RoboDoig/autonomouse-design/ConstructionManual/Olfactometer1.png

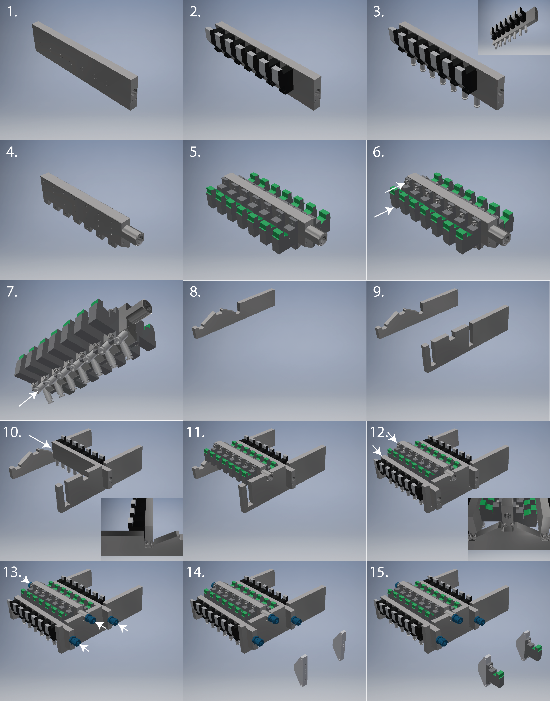
ConstructionManual/Olfactometer1.png
