RoboDoig/autonomouse-design/ConstructionManual/MainFrame2.png

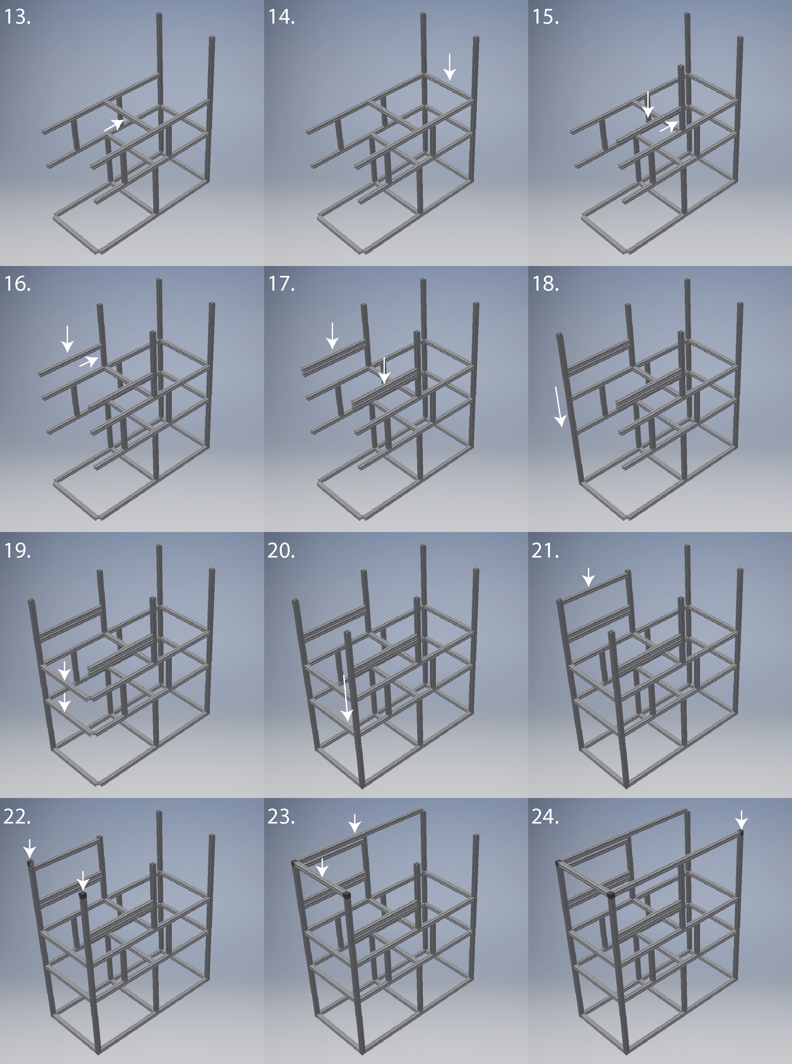
ConstructionManual/MainFrame2.png
