RoboDoig/autonomouse-design/README.md

# autonomouse-design
Design and schematic files for the AutonoMouse system
