RoboDoig/autonomouse-design/Diagrams/BehaviourPort.png

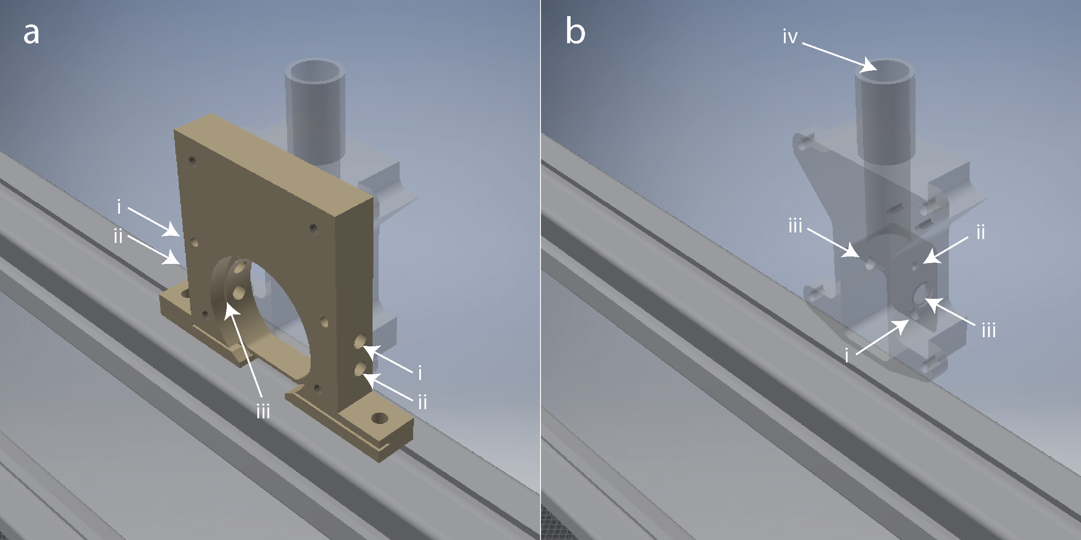
Diagrams/BehaviourPort.png
