RoboDoig/autonomouse-design/Diagrams/CageClean.png

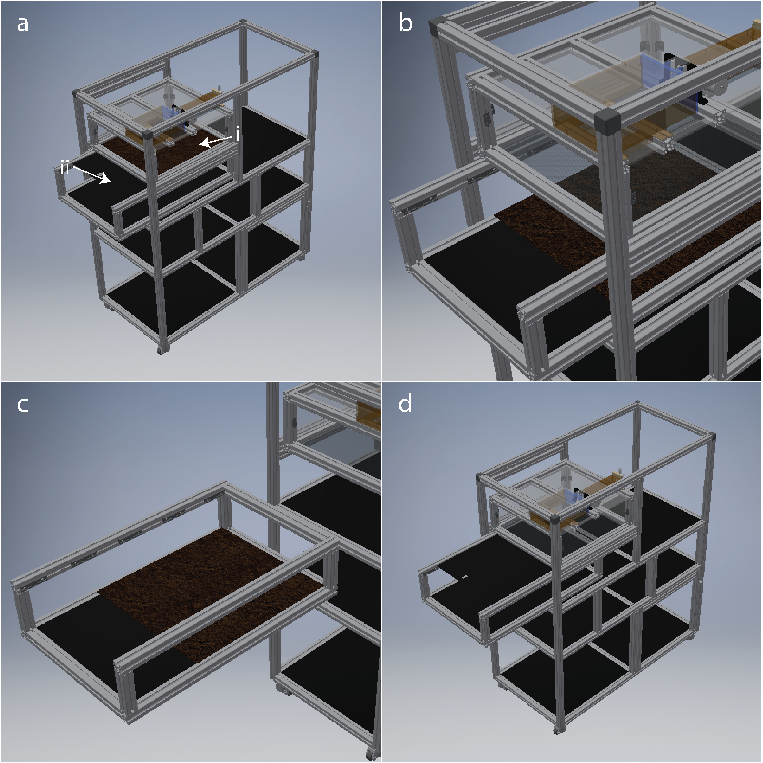
Diagrams/CageClean.png
