RoboDoig/autonomouse-design/Diagrams/FrameOnly.png

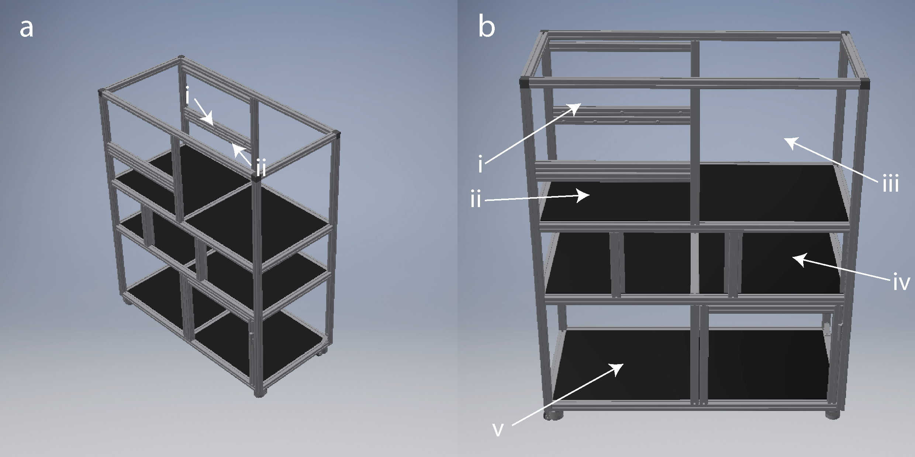
Diagrams/FrameOnly.png
