RoboDoig/autonomouse-design/SystemPictures/Pictures1.png

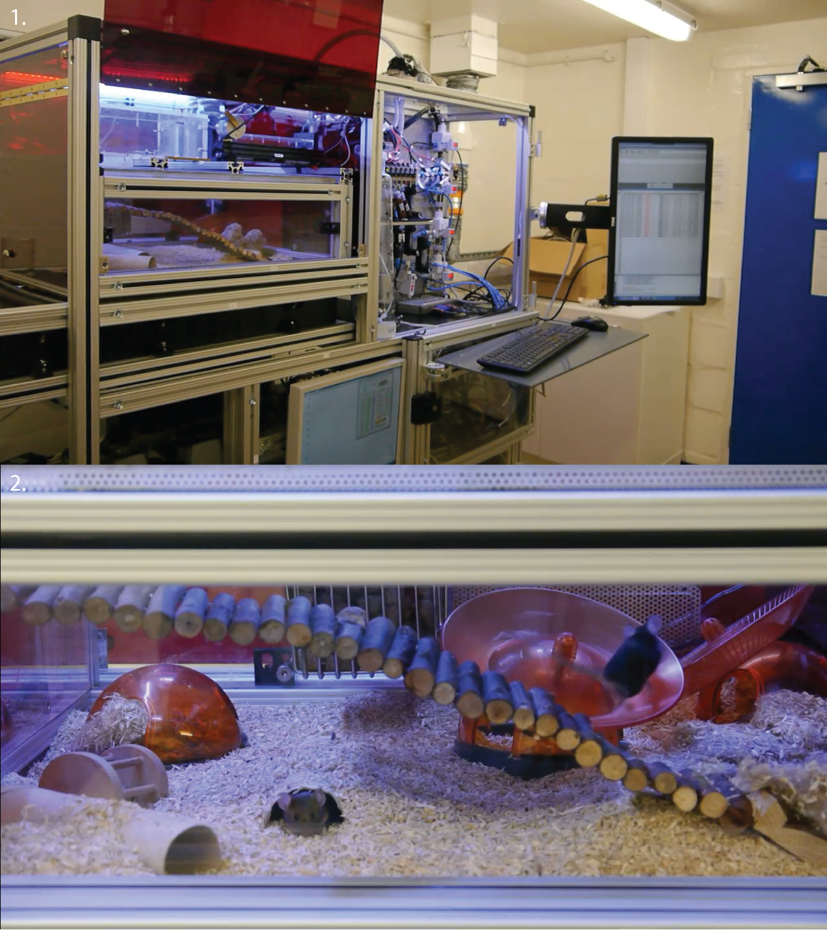
SystemPictures/Pictures1.png
