RoboDoig/autonomouse-design/SystemPictures/Pictures3.png

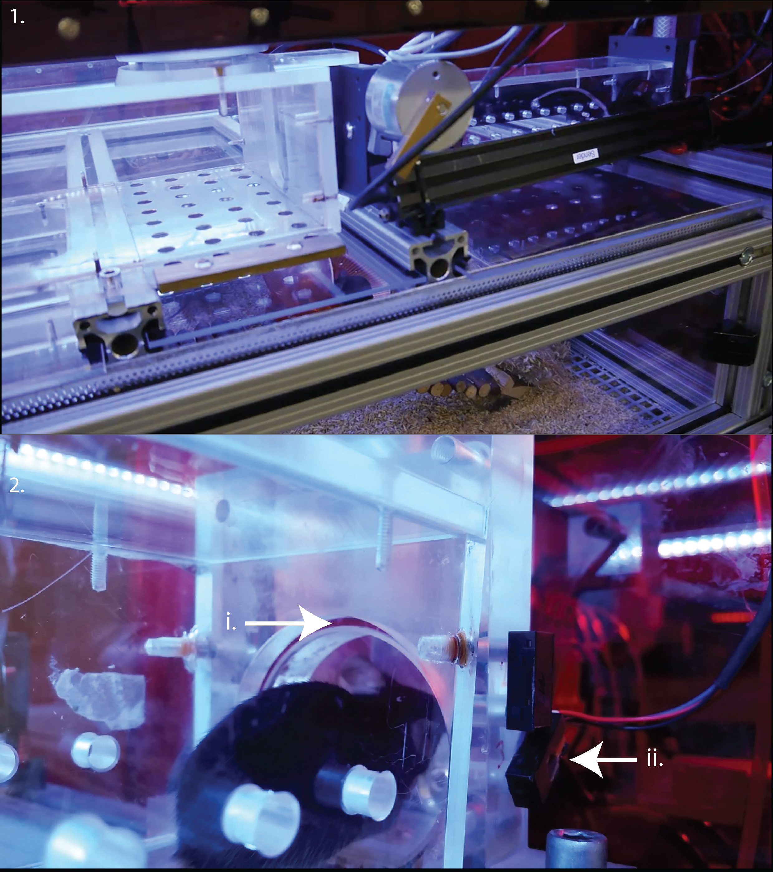
SystemPictures/Pictures3.png
