RoboDoig/autonomouse-design/SystemPictures/Pictures5.png

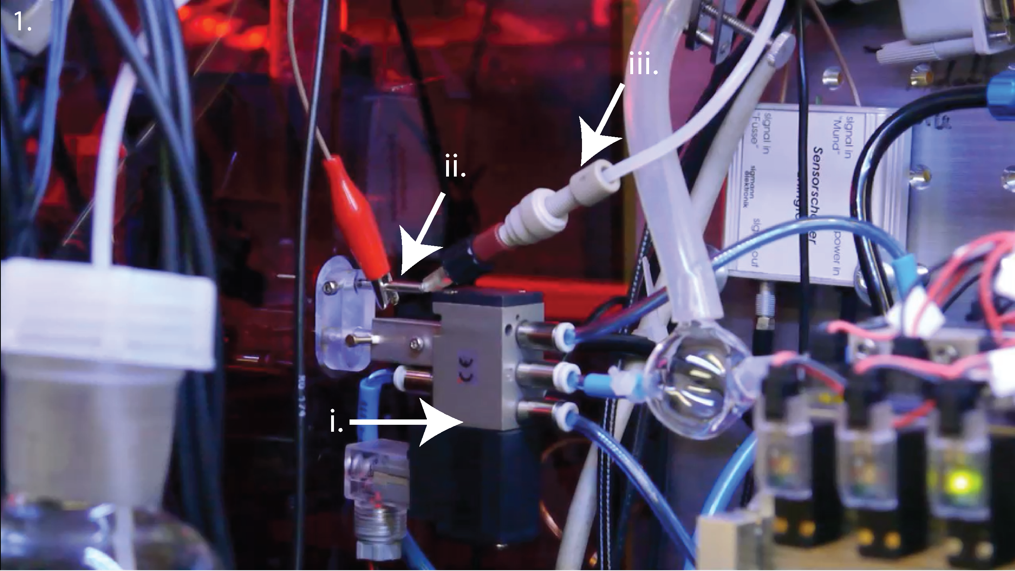
SystemPictures/Pictures5.png
