RoboDoig/autonomouse-design/ConstructionManual/PartsList.xlsx

Sheet: Main Frame
Item Name | Cut Length for Profiles (mm) | Quantity | Supplier | Catalog Code | Notes
Corner piece set cubica PA |  | 4 | MayTec | 1.48.14410
Profile 40x40 | 1627 | 4 | MayTec | 1.11.040040.43S | Cross bushing
Profile 40x40 | 1360 | 8 | MayTec | 1.11.040040.43S | Cross bushing
Profile 40x40 | 620 | 11 | MayTec | 1.11.040040.43S | Cross bushing
Profile 40x40 | 330 | 4 | MayTec | 1.11.040040.43S | Cross bushing
Profile 40x40 | 550 | 2 | MayTec | 1.11.040040.43S | Cross bushing
Profile 40x40 | 627 | 2 | MayTec | 1.11.040040.43S | Cross bushing
Profile 40x40 | 660 | 5 | MayTec | 1.11.040040.43S | Cross bushing
Profile 40x40 | 545 | 2 | MayTec | 1.11.040040.43S | Optional, cross bushing
Profile 40x40 | 572 | 1 | MayTec | 1.11.040040.43S | Optional, cross bushing
Slot roller |  | 14 | MayTec | 1.67.42E3M8
Hinges |  | 1 | MayTec | 1.62.842032085
Locking castor with plate |  | 4 | MayTec | 1.45.80200.073
Mounting block |  | 40 | MayTec | 1.64.153030.2 | Useful to order more for attachments etc.
Bottom plate |  | 6 | Custom (see repo)
Special mounting profile | 329 | 4 | MayTec | 1.19.19040 | Optional, requires drilling for installation

Sheet: Cleaning Chamber
Item Name | Cut Length for Profiles (mm) | Quantity | Supplier | Catalog Code | Notes
Profile 40x40 | 529.8 | 3 | MayTec | 1.11.040040.43S | Cross bushing
Profile 40x40 | 950 | 4 | MayTec | 1.11.040040.43S | Cross bushing
Profile 40x40 | 160 | 4 | MayTec | 1.11.040040.43S | Cross bushing
Hanging bracket |  | 10 | MayTec | 1.68.201050
Bottom plate |  | 1 | Custom (see repo)
Cleaning plate |  | 1 | Custom (see repo)

Sheet: Home Cage
Item Name | Cut Length for Profiles (mm) | Quantity | Supplier | Catalog Code | Notes
Profile 40x40 | 660 | 3 | MayTec | 1.11.040040.43S | Cross bushing
Profile 40x40 | 529.8 | 2 | MayTec | 1.11.040040.43S | Cross bushing
Profile 40x40 | 180 | 4 | MayTec | 1.11.040040.43S | Cross bushing
Profile 40x40 | 569.8 | 4 | MayTec | 1.11.040040.43S | Cross bushing
Mouting angle |  | 8 | MayTec | 1.64.5101
Home cage pre-chamber access floor |  | 1 | Custom (see repo)
Access floor 2 |  | 1 | Custom (see repo)
Access floor 3 |  | 1 | Custom (see repo)
Front cage panel removable |  | 2 | Custom (see repo)
Side cage panel removable |  | 2 | Custom (see repo)

Sheet: Behaviour Area
Item Name | Cut Length for Profiles (mm) | Quantity | Supplier | Catalog Code | Notes
Magnet frame |  | 1 | Custom (see repo)
Pre-chamber floor |  | 1 | Custom (see repo)
Pre-chamber wall |  | 1 | Custom (see repo)
Pre-chamber wall 2 |  | 1 | Custom (see repo)
Pre-chamber wall 3 |  | 1 | Custom (see repo)
Pre-chamber roof |  | 1 | Custom (see repo)
Pre-chamber front panel |  | 1 | Custom (see repo)
Pre-chamber linker |  | 1 | Custom (see repo)
Tunnel wall |  | 2 | Custom (see repo)
Tunnel roof |  | 1 | Custom (see repo)
Port linker |  | 1 | Custom (see repo)
Sensor port |  | 1 | Custom (see repo)
Spacer |  | 2 | Custom (see repo)
Pre-chamber mesh floor |  | 1 | Custom (see repo)
Tunnel mesh floor |  | 1 | Custom (see repo)
Motor holder |  | 1 | Custom (see repo)
Motor (110 degrees, 50mm 11W 24VDC) |  | 1 | RS Components | 400-8991
Door pole coupling |  | 1 | Custom (see repo)
Door pole |  | 1 | Custom (see repo)
Door adapter |  | 1 | Custom (see repo)
Door

Sheet: Sensors and Actuators
Item Name | Cut Length for Profiles (mm) | Quantity | Supplier | Catalog Code | Notes
IR beam detectors (PIE310/PID310D) |  | 10 | Kodenshi/Farnell | 1182343
Water pump (mzr-2521) |  | 1 | Mikrosysteme GmBH | 11 01 01 03
Pump controller (S-ND) |  | 1 | Mikrosysteme GmBH | 66 02 01 01
Pump cable extension |  | 1 | Mikrosysteme GmBH | 92 00 09 35
Pump tubing (0.5m) (1/8") |  | 2 | Mikrosysteme GmBH | 55 02 02 00
Pump filter (F-UP2) |  | 1 | Mikrosysteme GmBH | 54 02 01 01
Tubing screw insert (PEEK) |  | 1 | Mikrosysteme GmBH | 51 01 02 02
Check valve RSC-UP-210 |  | 1 | Mikrosysteme GmBH | 41 03 01 00
Fluid adapter (PEEK) |  | 1 | Mikrosysteme GmBH | 52 02 03 02
Water port (ID 0.16 mm) |  | 1 | Mikrosysteme GmBH | 58 01 09 06
RFID single coil antenna (52mm diameter) |  | 1
RFID decoder |  | 1 | Trovan | LID-665 OEM

Sheet: Connectors
Item Name | Cut Length for Profiles (mm) | Quantity | Supplier | Catalog Code | Notes
Universal connector |  | 100 | MayTec | 1.21.4E0E | Useful to order more (~50) for subsequent connections
T-nut (M6) |  | 100 | MayTec | 1.32.4EM6 | Useful to order more (~50) for subsequent connections
T-nut (M8) |  | 14 | MayTec | 1.70.10EM8
Quick Lock (E slot) |  | 8 | MayTec | 1.32.4F2M4.25
Quick Lock (Bolt) |  | 8 | MayTec | 1.64.5419 | For different panel thicknesses use different Hmax value. Hmax should be > panel thickness
Profile end cap |  |  | MayTec | 1.42.20404.2 | Optional (caps off hard edges of profiles)
Installation ring |  |  | MayTec | 1.71.30365 | Optional (useful for cable organisation)
T-nut (M5) |  |  | MayTec | 1.32.4EM5 | Optional (attachment for installation rings)

Sheet: Olfactometer
Item Name | Cut Length for Profiles (mm) | Quantity | Supplier | Catalog Code | Notes
Front holder |  | 1 | Custom (see repo)
Back holder |  | 1 | Custom (see repo)
Input valve block (left) |  | 1 | Custom (see repo)
Input valve block (right) |  | 1 | Custom (see repo)
Main valve block |  | 1 | Custom (see repo)
Input valve |  | 14 | Asco / Numatics | 18801088
Main valve |  | 14 | Asco / Numatics | SCS067A028
Pre-line valve |  | 2 | Asco / Numatics | SCS067A108
Straight threaded-to-tube adapter, M5 x 0.8, push in 4mm |  | 28 | SMC | KQ2S04-M5N
Quick tubing connector |  | 10 | Festo | 2027 CK-1/8-PK-4
Hex socket cap screw (M3, 10cm) |  | 6 | RS Pro | 660-4636
Hex socket cap screw (M3, 6cm) |  | 32 | RS Pro | 280-981
Subbase for main valve |  | 2 | Asco / Numatics | 36100040
Subbase adapter |  | 6 | Custom (see repo)
