RoboDoig/autonomouse-design/(list of files, cad)

Other CAD files:
AutonoMouseSchematics/AccessFloor2.ipt
AutonoMouseSchematics/AccessFloor3.ipt
AutonoMouseSchematics/AutonoMouse.iam
AutonoMouseSchematics/BottomPlate.ipt
AutonoMouseSchematics/BottomPlate2.ipt
AutonoMouseSchematics/BottomPlate3.ipt
AutonoMouseSchematics/CageFloor.ipt
AutonoMouseSchematics/CleaningPlate.ipt
AutonoMouseSchematics/Door.ipt
AutonoMouseSchematics/DoorAdapter.ipt
AutonoMouseSchematics/DoorPole.ipt
AutonoMouseSchematics/DoorPoleCoupling.ipt
AutonoMouseSchematics/FrontCagePanelRemovable.ipt
AutonoMouseSchematics/HomeCagePreChamberAccessFloor.ipt
AutonoMouseSchematics/MagnetFrame.ipt
AutonoMouseSchematics/May Tec 1_47_225160_2_Floor mounting plate_schwarz-Pulverbeschichtet.ipt
AutonoMouseSchematics/May Tec 1_48_14410_Corner piece set cubic PA.ipt
AutonoMouseSchematics/May Tec 1_63_14041_3_Clamping stud 40x40.ipt
AutonoMouseSchematics/May Tec 1_63_14041_Base plates.ipt
AutonoMouseSchematics/May Tec 1_63_14041_Clamping lever 80.ipt
AutonoMouseSchematics/May Tec 1_64_153030_2_Mounting blocks GD-Zn_schwarz 0.ipt
AutonoMouseSchematics/May Tec 1_64_5101__Mounting angle.ipt
AutonoMouseSchematics/May Tec 1_71_30365_Installation ring_36_5.ipt
AutonoMouseSchematics/MayTec 1_11_030030_43SP_Profile 30x30_ 4F, SP_50_Detail_(0;0,0,0).ipt
AutonoMouseSchematics/MayTec 1_11_030030_43SP_Profile 30x30_ 4F, SP_910_Detail_(0;0,0,0).ipt
AutonoMouseSchematics/MayTec 1_11_040040_43S_Profile 40x40, 4E, S_1360_Detail_(0;0,0,0).ipt
AutonoMouseSchematics/MayTec 1_11_040040_43S_Profile 40x40, 4E, S_160_Detail_(0;0,0,0).ipt
AutonoMouseSchematics/MayTec 1_11_040040_43S_Profile 40x40, 4E, S_1627_Detail_(0;0,0,0).ipt
AutonoMouseSchematics/MayTec 1_11_040040_43S_Profile 40x40, 4E, S_180_Detail_(0;0,0,0).ipt
AutonoMouseSchematics/MayTec 1_11_040040_43S_Profile 40x40, 4E, S_330_Detail_(0;0,0,0).ipt
AutonoMouseSchematics/MayTec 1_11_040040_43S_Profile 40x40, 4E, S_529_8_Detail_(0;0,0,0).ipt
AutonoMouseSchematics/MayTec 1_11_040040_43S_Profile 40x40, 4E, S_545_Detail_(0;0,0,0).ipt
AutonoMouseSchematics/MayTec 1_11_040040_43S_Profile 40x40, 4E, S_550_Detail_(0;0,0,0).ipt
AutonoMouseSchematics/MayTec 1_11_040040_43S_Profile 40x40, 4E, S_569_8_Detail_(0;0,0,0).ipt
AutonoMouseSchematics/MayTec 1_11_040040_43S_Profile 40x40, 4E, S_572_Detail_(0;0,0,0).ipt
AutonoMouseSchematics/MayTec 1_11_040040_43S_Profile 40x40, 4E, S_609_8_Detail_(0;0,0,0).ipt
AutonoMouseSchematics/MayTec 1_11_040040_43S_Profile 40x40, 4E, S_620_Detail_(0;0,0,0).ipt
AutonoMouseSchematics/MayTec 1_11_040040_43S_Profile 40x40, 4E, S_627_Detail_(0;0,0,0).ipt
AutonoMouseSchematics/MayTec 1_11_040040_43S_Profile 40x40, 4E, S_660_Detail_(0;0,0,0).ipt
AutonoMouseSchematics/MayTec 1_11_040040_43S_Profile 40x40, 4E, S_700_Detail_(0;0,0,0).ipt
AutonoMouseSchematics/MayTec 1_11_040040_43S_Profile 40x40, 4E, S_740_Detail_(0;0,0,0).ipt
AutonoMouseSchematics/MayTec 1_11_040040_43S_Profile 40x40, 4E, S_950_Detail_(0;0,0,0).ipt
AutonoMouseSchematics/MayTec 1_19_19040_19 inch special profile, PG 40_329.ipt
AutonoMouseSchematics/MayTec 1_45_80200_073_Locking castor 200kg, with plate - Kopie.ipt
AutonoMouseSchematics/MayTec 1_45_80200_073_Locking castor 200kg, with plate.ipt
AutonoMouseSchematics/MayTec 1_46_20639_Angle Alu 60x60, D9_0, B30.ipt
AutonoMouseSchematics/MayTec 1_62_842032085_Alu hinges, heavy, type 20 PG 40 (0).ipt
AutonoMouseSchematics/MayTec 1_62_842032085_Alu hinges, heavy, type 20 PG 40 (180).ipt
AutonoMouseSchematics/MayTec 1_62_842032085_Alu hinges, heavy, type 20 PG 40 (90).ipt
AutonoMouseSchematics/MayTec 1_67_42E3M8_Slot roller E3.ipt
AutonoMouseSchematics/MayTec 1_68_201050_Hanging bracket.ipt
AutonoMouseSchematics/MeshFloor.ipt
AutonoMouseSchematics/Motor.ipt
AutonoMouseSchematics/MotorHolder.ipt
AutonoMouseSchematics/PortLinker.ipt
AutonoMouseSchematics/PreChamberFloor.ipt
AutonoMouseSchematics/PreChamberFrontPanel.ipt
AutonoMouseSchematics/PreChamberLinker.ipt
AutonoMouseSchematics/PreChamberRoof.ipt
AutonoMouseSchematics/PreChamberWall.ipt
AutonoMouseSchematics/PreChamberWall2.ipt
AutonoMouseSchematics/PreChamberWall3.ipt
AutonoMouseSchematics/SensorPort.ipt
AutonoMouseSchematics/SideCagePanelRemovable.ipt
AutonoMouseSchematics/Spacer.ipt
AutonoMouseSchematics/TunnelRoof.ipt
AutonoMouseSchematics/TunnelWall.ipt
OlfactometerSchematics/2027 CK-1_8-PK-4.ipt
OlfactometerSchematics/BackHolder.ipt
OlfactometerSchematics/FrontHolder.ipt
OlfactometerSchematics/InputBlockLeft.ipt
OlfactometerSchematics/InputBlockRight.ipt
OlfactometerSchematics/MainBlock.ipt
OlfactometerSchematics/MainValve.ipt
OlfactometerSchematics/NumaticsValve.ipt
OlfactometerSchematics/OldVersions/2027 CK-1_8-PK-4.0001.ipt
OlfactometerSchematics/OldVersions/BackHolder.0002.ipt
OlfactometerSchematics/OldVersions/FrontHolder.0003.ipt
OlfactometerSchematics/OldVersions/InputBlockLeft.0011.ipt
OlfactometerSchematics/OldVersions/InputBlockRight.0012.ipt
OlfactometerSchematics/OldVersions/MainBlock.0010.ipt
OlfactometerSchematics/OldVersions/MainValve.0002.ipt
OlfactometerSchematics/OldVersions/NumaticsValve.0004.ipt
OlfactometerSchematics/OldVersions/Olfactometer.0006.iam
OlfactometerSchematics/OldVersions/PipeFitting.0002.ipt
OlfactometerSchematics/OldVersions/Subbase.0002.ipt
OlfactometerSchematics/OldVersions/SubbaseAdapter.0001.ipt
OlfactometerSchematics/Olfactometer.iam
OlfactometerSchematics/PipeFitting.ipt
OlfactometerSchematics/Subbase.ipt
OlfactometerSchematics/SubbaseAdapter.ipt
