RoboDoig/autonomouse-design/ConstructionManual/BehaviourPort1.png

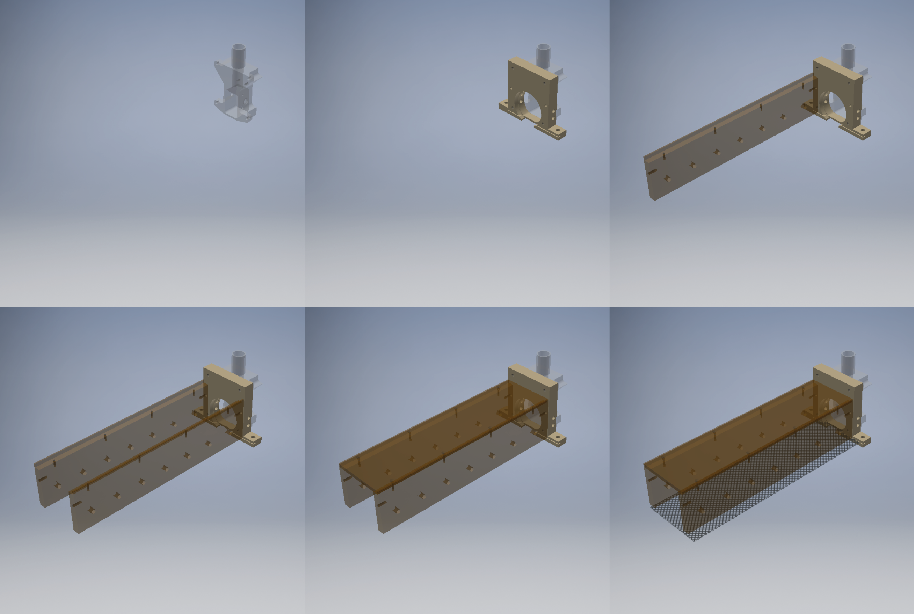
ConstructionManual/BehaviourPort1.png
