RoboDoig/autonomouse-design/ConstructionManual/CleaningBin1.png

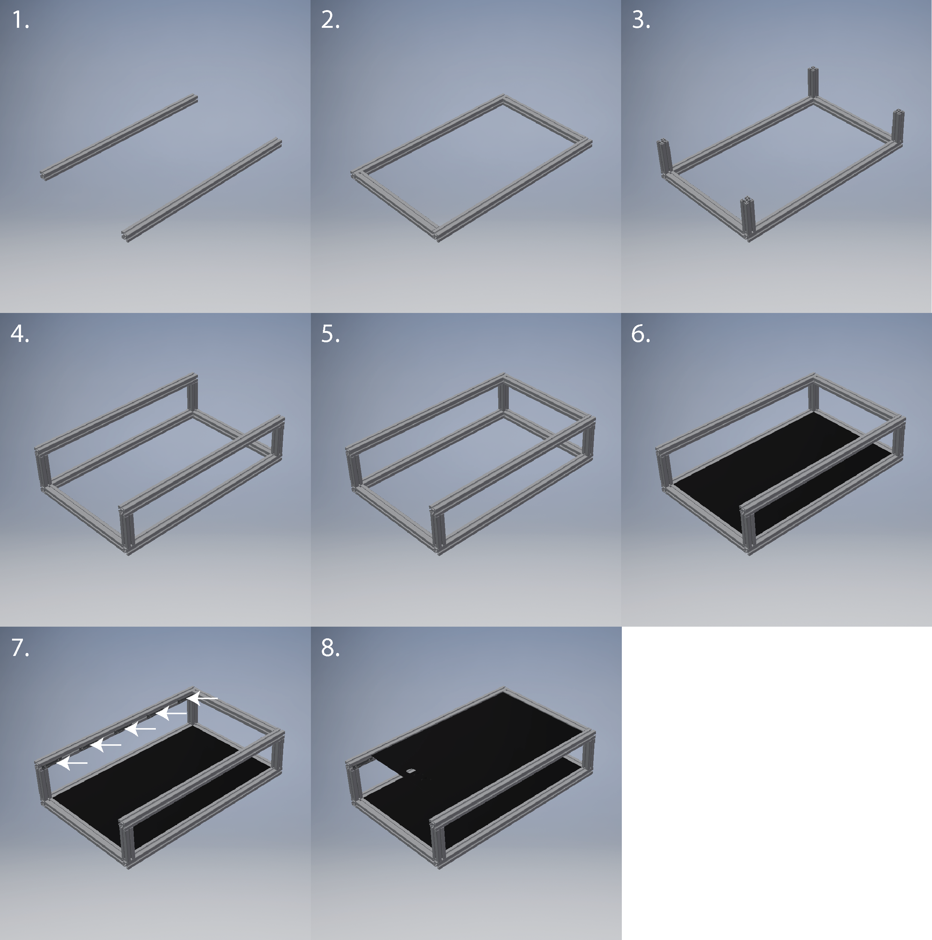
ConstructionManual/CleaningBin1.png
