RoboDoig/autonomouse-design/ConstructionManual/DoorMechanism1.png

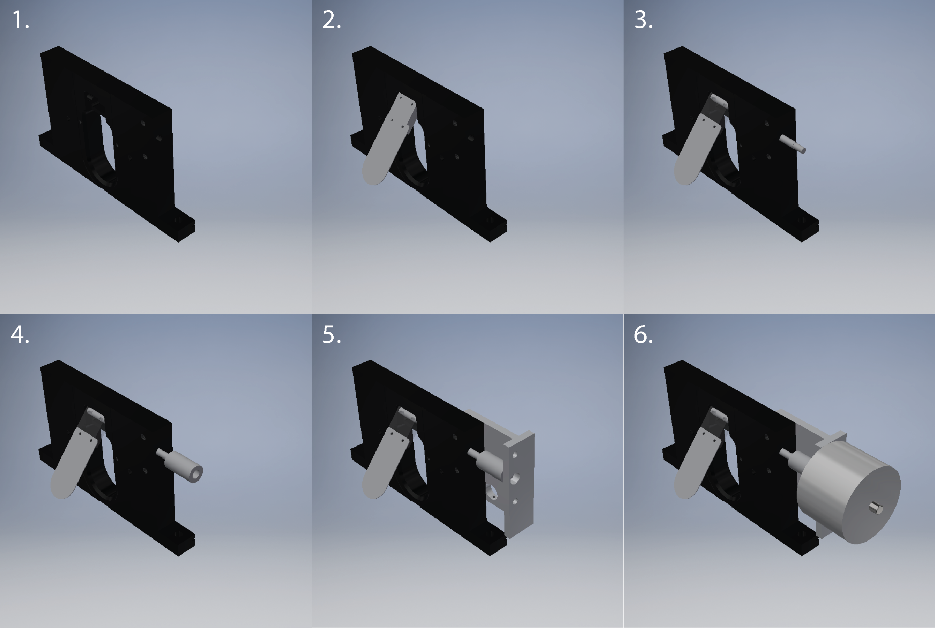
ConstructionManual/DoorMechanism1.png
