RoboDoig/autonomouse-design/ConstructionManual/MainFrame1.png

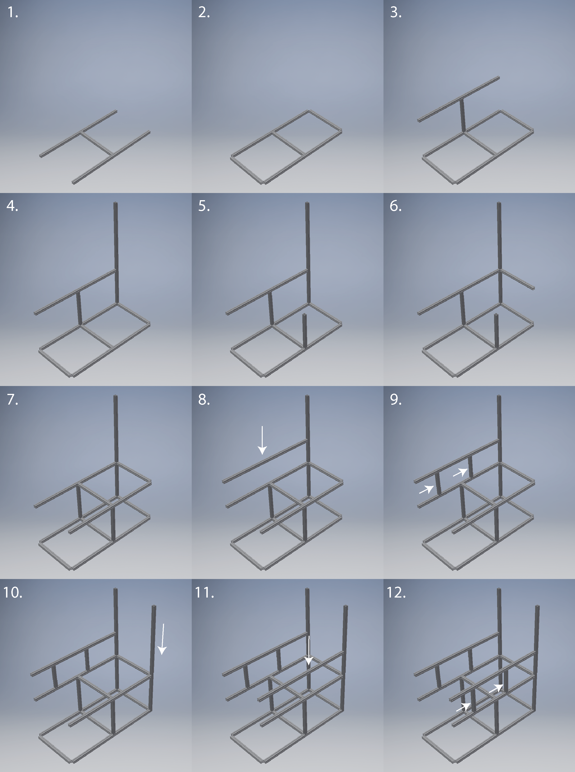
ConstructionManual/MainFrame1.png
