RoboDoig/autonomouse-design/ConstructionManual/MainFrame3.png

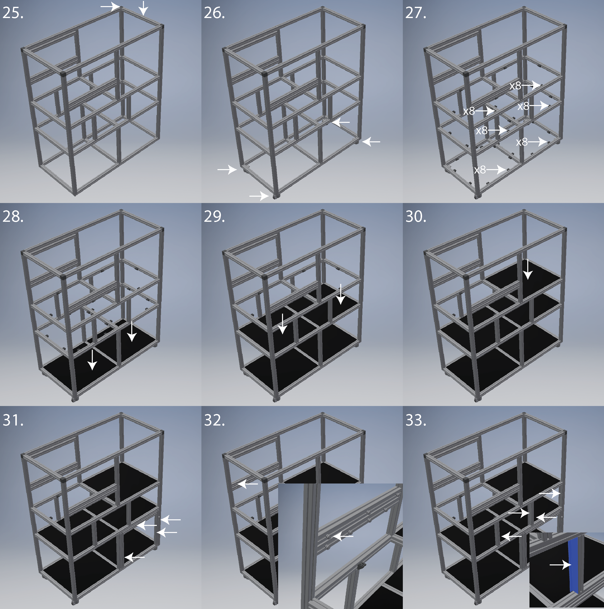
ConstructionManual/MainFrame3.png
