RoboDoig/autonomouse-design/ConstructionManual/Olfactometer2.png

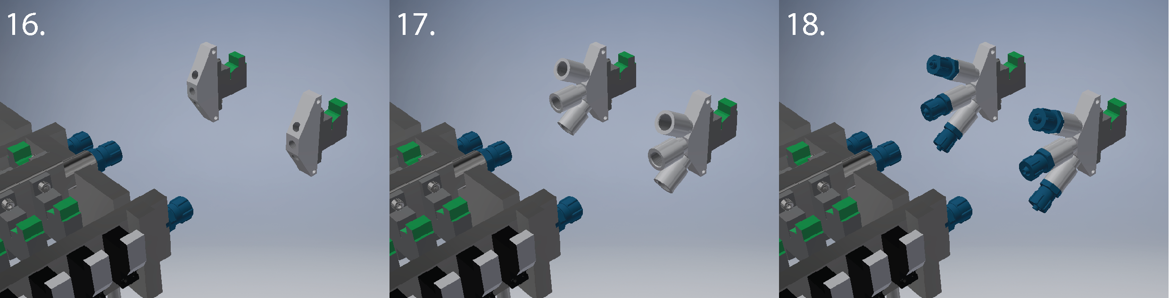
ConstructionManual/Olfactometer2.png
