RoboDoig/autonomouse-design/ConstructionManual/PreChamber1.png

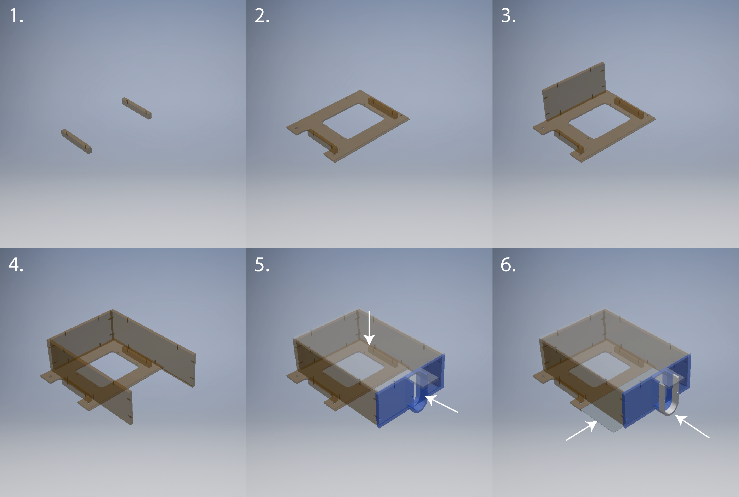
ConstructionManual/PreChamber1.png
