RoboDoig/autonomouse-design/Diagrams/CageConstruction.png

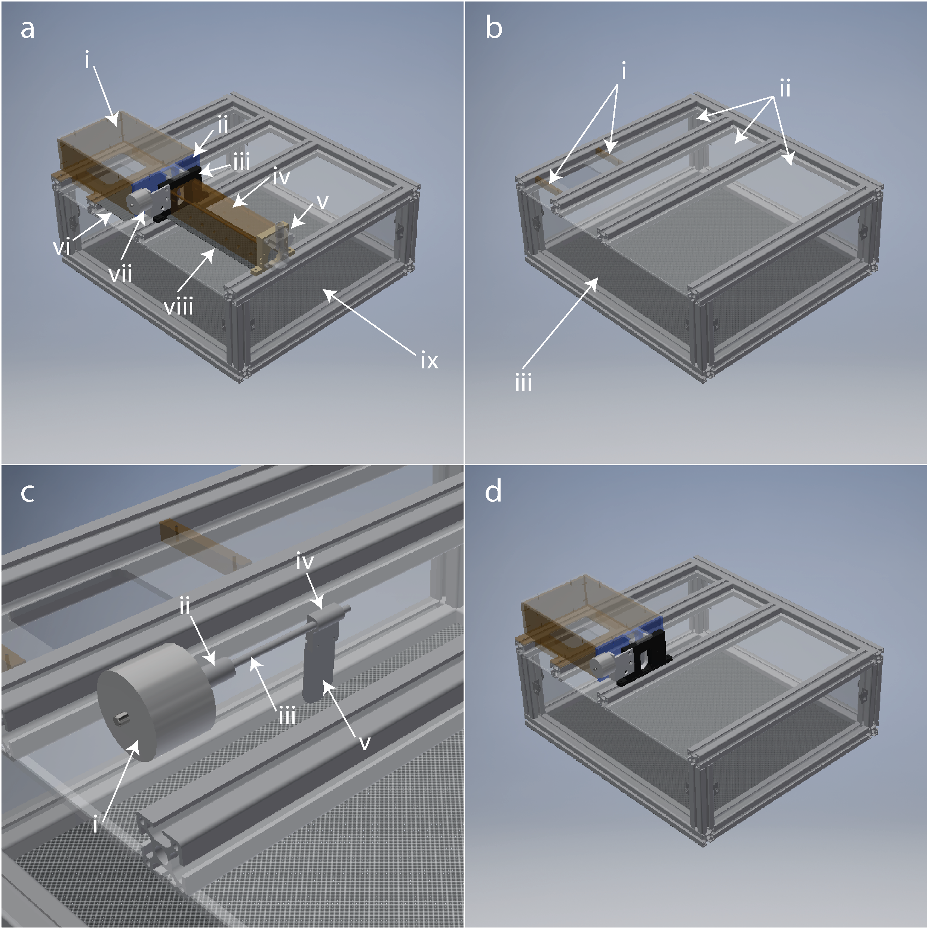
Diagrams/CageConstruction.png
