RoboDoig/autonomouse-design/Diagrams/DoorOperation.png

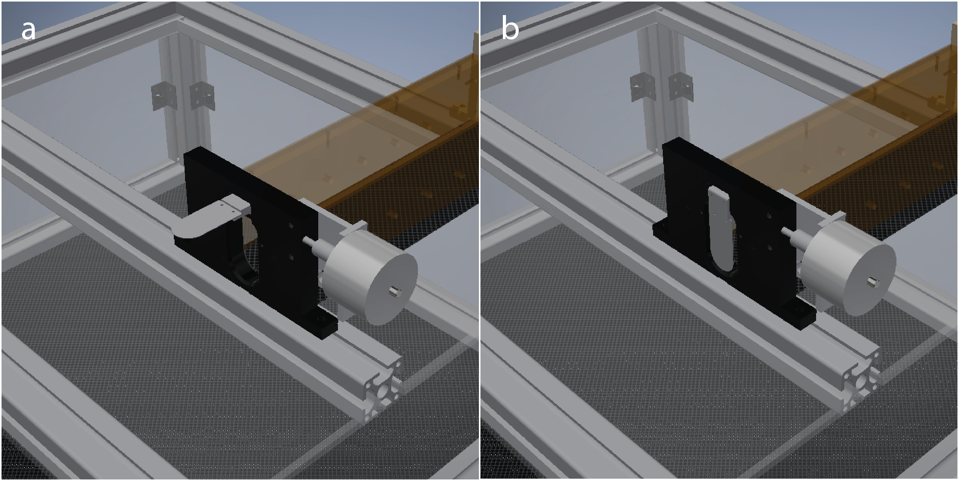
Diagrams/DoorOperation.png
