RoboDoig/autonomouse-design/Diagrams/FullFrameConstruction.png

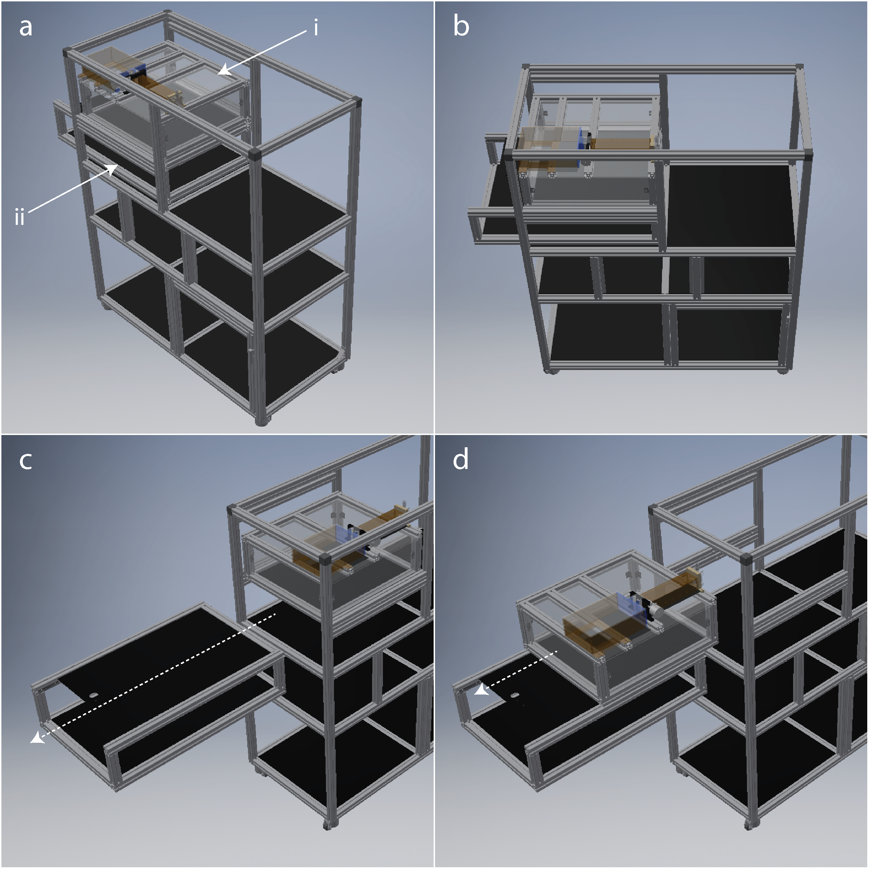
Diagrams/FullFrameConstruction.png
