RoboDoig/autonomouse-design/(commit log)

2018-02-21 Added electronics
    [door-close.sch, ir-logic.sch, lick-detector.sch]
2018-02-21 Labels for electronics modules
    [door-close.sch, ir-logic.sch, lick-detector.sch]
2018-02-27 Circuit schematics update
    [door-close.sch, ir-logic.sch, lick-detector.sch, ~lick-detector.sch]
2018-03-28 Update with quick lock codes
    [PartsList.xlsx]
